dojoe/btclock/hw/fanout.pdf

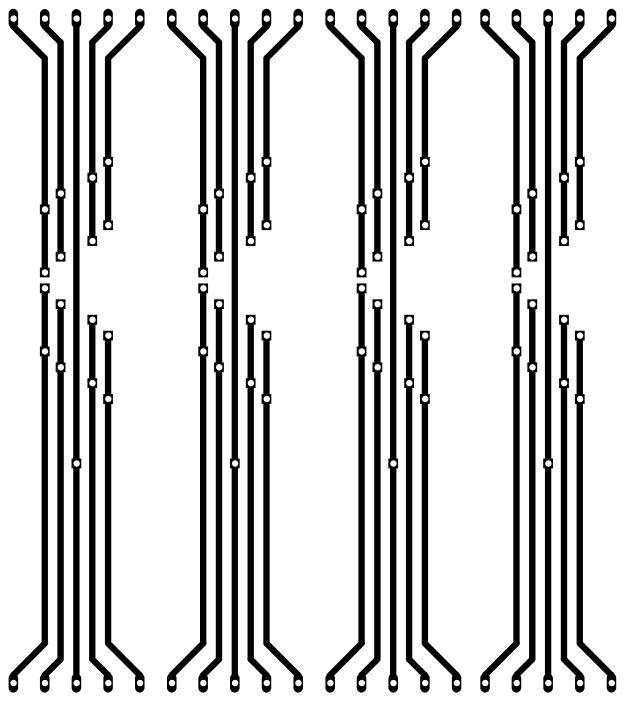
[picture p1: page 1]
