dojoe/btclock/hw/clock.brd

## EAGLE design hw/clock.brd (2013-02-22)

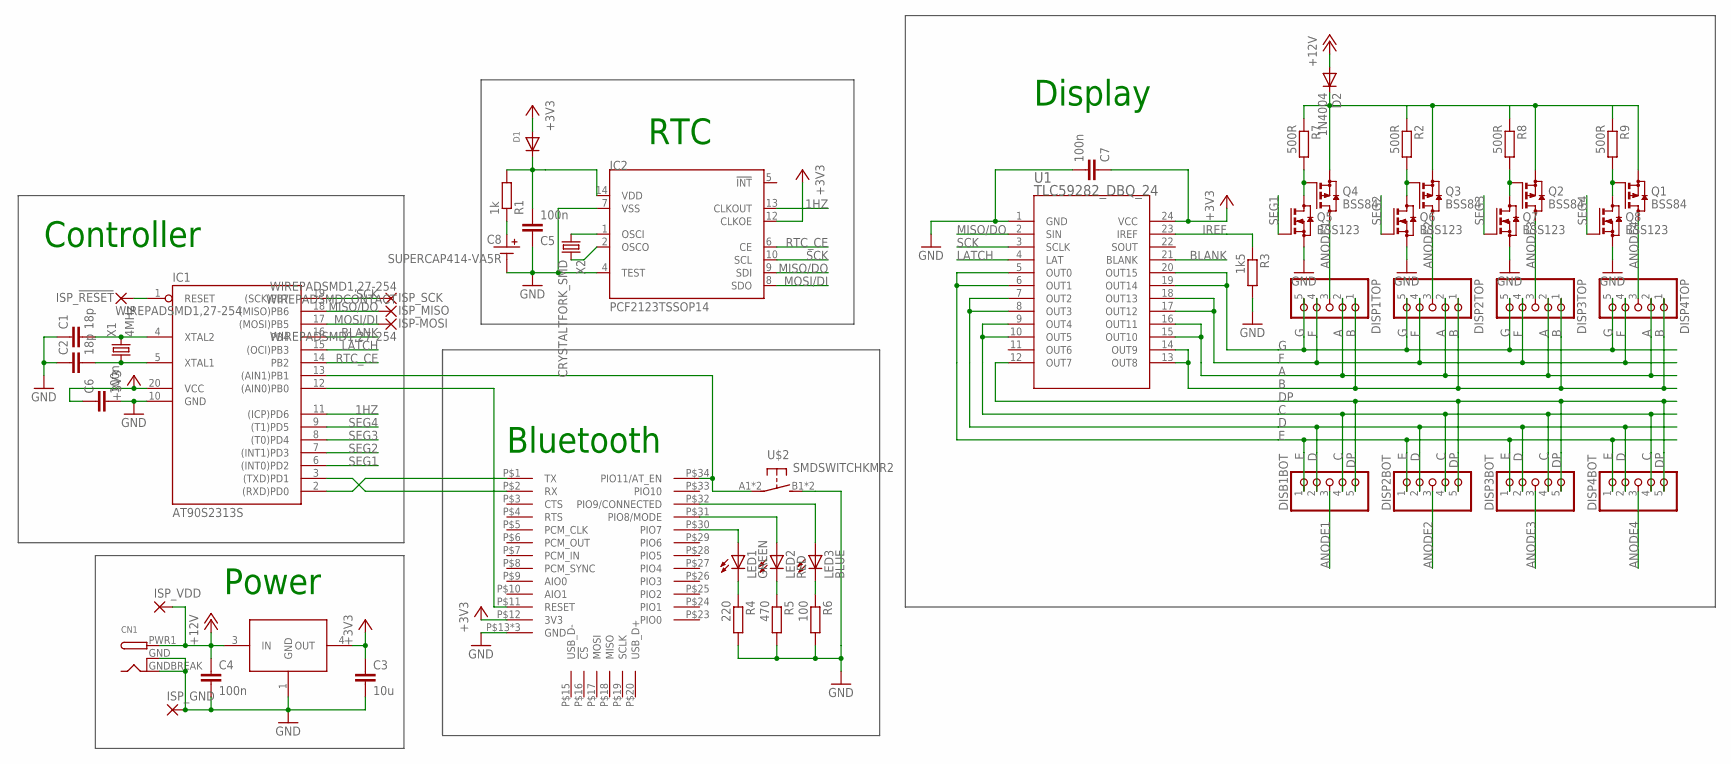
[picture p2: schematic clock.sch]

Parts:
C1, C2: 18p; C0603K
C3: 10u; C0805K
C4, C5, C6, C7: 100n; C0603K
C8: SUPERCAP414-VA5R; 414-VA5R
CN1: DCBARRELSMT; DCJACK_2MM_SMT
D1: DIODESOD-523; SOD-523
D2: 1N4004; DO41-10
DISB1BOT: PINHD-1X5; 1X05WIDE
DISP1TOP, DISP2BOT, DISP2TOP, DISP3BOT, DISP3TOP, DISP4BOT, DISP4TOP: PINHD-1X5; 1X05WIDE
IC1: AT90S2313S; SO20L
IC2: PCF2123TSSOP14; TSSOP14
ISP-MOSI: WIREPADSMD1,27-254; SMD1,27-2,54
ISP_!RESET: WIREPADSMD1,27-254; SMD1,27-2,54
ISP_GND: WIREPADSMD2,54-2,54; SMD2,54-2,54
ISP_MISO: WIREPADSMDCONTACT; SMDCONTACT
ISP_SCK: WIREPADSMD1,27-254; SMD1,27-2,54
ISP_VDD: WIREPADSMD2,54-2,54; SMD2,54-2,54
LED1: GREEN; CHIPLED_0805
LED2: RED; CHIPLED_0805
LED3: BLUE; CHIPLED_0805
Q1, Q2, Q3, Q4: BSS84; SOT23
Q5, Q6, Q7, Q8: BSS123; SOT23
R1: 1k; R0603
R2, R7, R8, R9: 500R; R0603
R3: 1k5; R0603
R4: 220; R0603
R5: 470; R0603
R6: 100; R0603
U1: TLC59282_DBQ_24; DBQ24
U$1: BT-HC-05
U$2: SMDSWITCHKMR2; KMR2
U$3: REGULATORDPAK; DPAK
X1: 4MHz; HC49UP
X2: CRYSTALTFORK_SMD; TFORK_SMD

Connections:
1HZ: IC1.11 ((ICP)PD6), IC2.13 (CLKOUT)
+3V3: C3.1, C6.1, C7.1, D1.A, IC1.20 (VCC), IC2.12 (CLKOE), U1.24 (VCC), U$1.P$12 (3V3), U$3.4 (OUT)
+12V: C4.1, CN1.PWR1 (PWR), D2.A, ISP_VDD.1, U$3.3 (IN)
A: DISP1TOP.2, DISP2TOP.2, DISP3TOP.2, DISP4TOP.2, U1.15 (OUT10), U1.16 (OUT11)
ANODE1: DISB1BOT.3, DISP1TOP.3, Q4.3 (D)
ANODE2: DISP2BOT.3, DISP2TOP.3, Q3.3 (D)
ANODE3: DISP3BOT.3, DISP3TOP.3, Q2.3 (D)
ANODE4: DISP4BOT.3, DISP4TOP.3, Q1.3 (D)
B: DISP1TOP.1, DISP2TOP.1, DISP3TOP.1, DISP4TOP.1, U1.13 (OUT8), U1.14 (OUT9)
BLANK: IC1.16 (PB4), U1.21 (BLANK)
C: DISB1BOT.4, DISP2BOT.4, DISP3BOT.4, DISP4BOT.4, U1.9 (OUT4), U1.10 (OUT5)
D: DISB1BOT.2, DISP2BOT.2, DISP3BOT.2, DISP4BOT.2, U1.7 (OUT2), U1.8 (OUT3)
DP: DISB1BOT.5, DISP2BOT.5, DISP3BOT.5, DISP4BOT.5, U1.12 (OUT7)
E: DISB1BOT.1, DISP2BOT.1, DISP3BOT.1, DISP4BOT.1, U1.5 (OUT0), U1.6 (OUT1)
F: DISP1TOP.4, DISP2TOP.4, DISP3TOP.4, DISP4TOP.4, U1.17 (OUT12), U1.18 (OUT13)
G: DISP1TOP.5, DISP2TOP.5, DISP3TOP.5, DISP4TOP.5, U1.19 (OUT14), U1.20 (OUT15)
GND: C1.1, C2.1, C3.2, C4.2, C5.1, C6.2, C7.2, C8.MINUS, CN1.GND (GNDBREAK), CN1.GNDBREAK (GND), IC1.10 (GND), IC2.4 (TEST), IC2.7 (VSS), ISP_GND.1, Q5.2 (S), Q6.2 (S), Q7.2 (S), Q8.2 (S), R3.2, R4.2, R5.2, R6.2, U1.1 (GND), U$1.P$13 (GND), U$1.P$21 (GND), U$1.P$22 (GND), U$2.B1 (S), U$2.B2 (S), U$3.1 (GND)
IREF: R3.1, U1.23 (IREF)
LATCH: IC1.15 ((OCI)PB3), U1.4 (LAT)
MISO/DO: IC1.18 ((MISO)PB6), IC2.9 (SDI), ISP_MISO.1, U1.2 (SIN)
MOSI/DI: IC1.17 ((MOSI)PB5), IC2.8 (SDO), ISP-MOSI.1
unnamed: IC1.2 ((RXD)PD0), U$1.P$1 (TX)
unnamed: IC1.3 ((TXD)PD1), U$1.P$2 (RX)
unnamed: IC2.2 (OSCO), X2.3 (2)
unnamed: IC2.1 (OSCI), X2.2 (1)
unnamed: C2.2, IC1.5 (XTAL1), X1.1
unnamed: C1.2, IC1.4 (XTAL2), X1.2
unnamed: IC1.1 (RESET), ISP_!RESET.1
unnamed: IC1.13 ((AIN1)PB1), U$1.P$34 (PIO11/AT_EN), U$2.A1, U$2.A2
unnamed: C8.PLUS, R1.1
unnamed: IC1.12 ((AIN0)PB0), U$1.P$11 (RESET)
unnamed: D2.C, Q1.2 (S), Q2.2 (S), Q3.2 (S), Q4.2 (S), R2.1, R7.1, R8.1, R9.1
unnamed: LED1.C, R4.1
unnamed: LED2.C, R5.1
unnamed: LED3.C, R6.1
unnamed: LED3.A, U$1.P$32 (PIO9/CONNECTED)
unnamed: LED2.A, U$1.P$31 (PIO8/MODE)
unnamed: LED1.A, U$1.P$30 (PIO7)
unnamed: Q1.1 (G), Q8.3 (D), R9.2
unnamed: Q2.1 (G), Q7.3 (D), R8.2
unnamed: Q3.1 (G), Q6.3 (D), R2.2
unnamed: Q4.1 (G), Q5.3 (D), R7.2
RTC_CE: IC1.14 (PB2), IC2.6 (CE)
SCK: IC1.19 ((SCK)PB7), IC2.10 (SCL), ISP_SCK.1, U1.3 (SCLK)
SEG1: IC1.6 ((INT0)PD2), Q5.1 (G)
SEG2: IC1.7 ((INT1)PD3), Q6.1 (G)
SEG3: IC1.8 ((T0)PD4), Q7.1 (G)
SEG4: IC1.9 ((T1)PD5), Q8.1 (G)
VRTC: C5.2, D1.K (C), IC2.14 (VDD), R1.2

Notes on the sheet:
Power
RTC
Controller
Bluetooth
Display

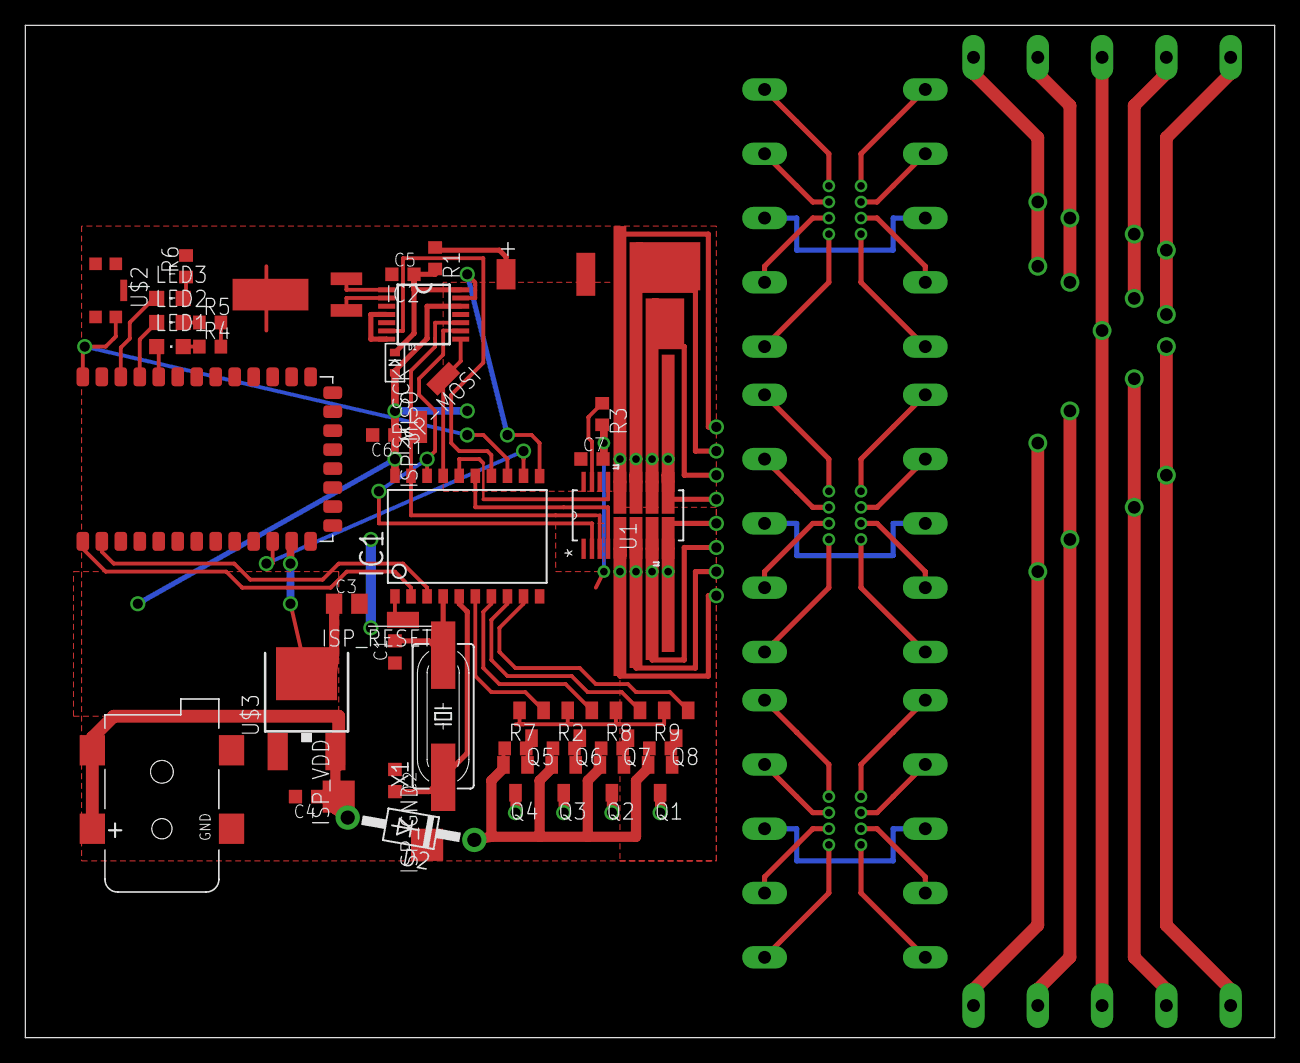
[picture p3: board clock.brd from above]

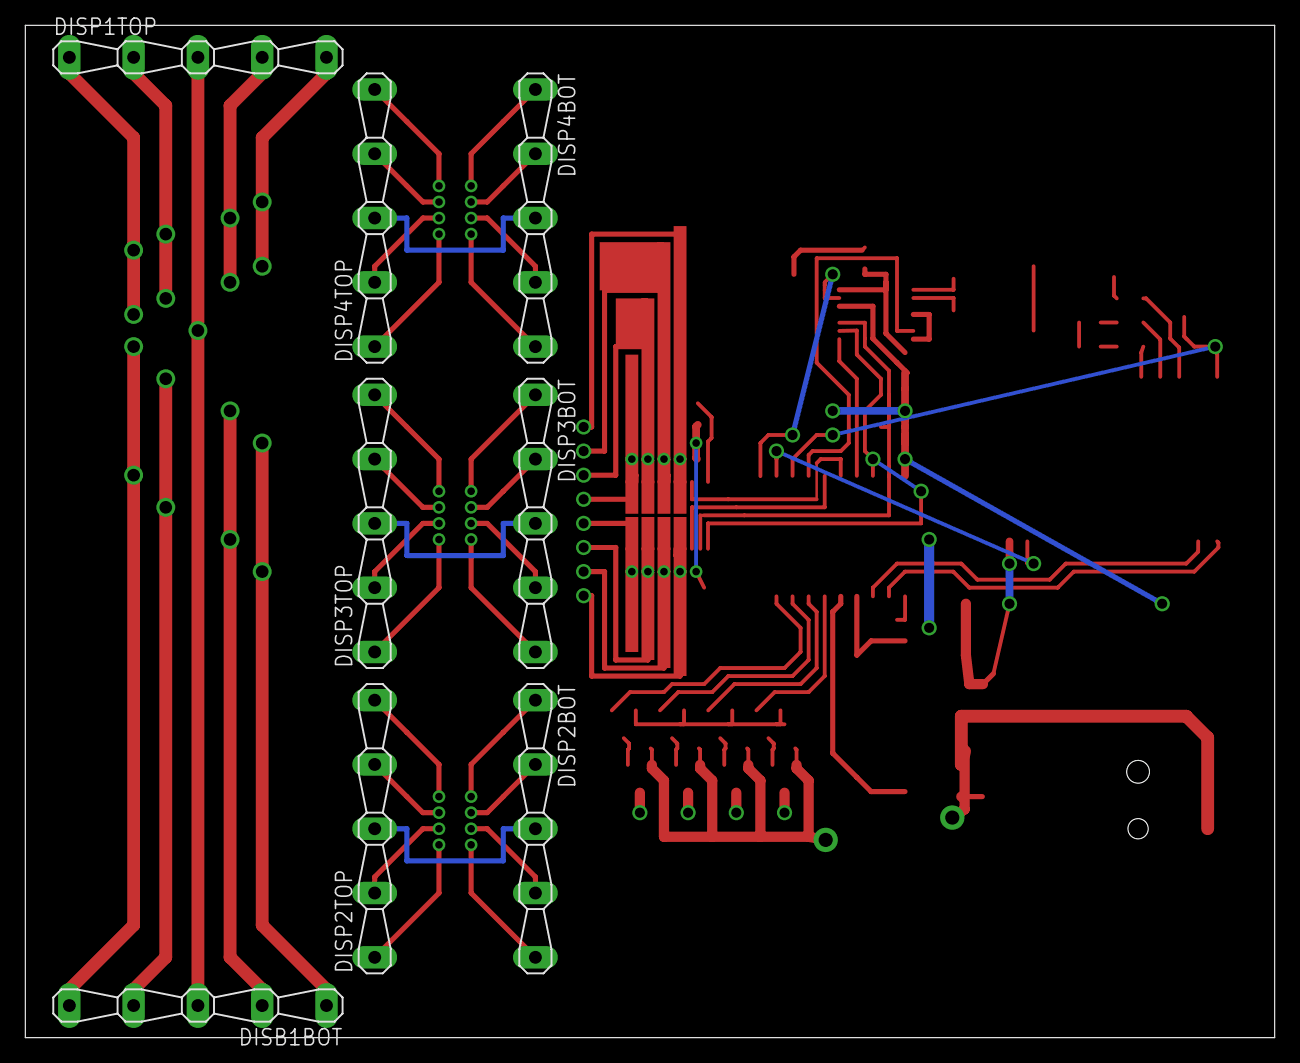
[picture p4: board clock.brd from below]

Board: 2 copper layers, 98.7 x 80.0 mm, 53 parts (8 on the bottom side), 49 nets.
