dojoe/btclock/(commit log)

2013-01-31 Initial commit, including reverse SPI bug on PCB
    [bom.csv, clock.brd, clock.sch]
2013-01-31 Fix reversed SPI lines, remove superfluous pull-up on RTC.CLKOUT, improve vias.
    [clock.brd, clock.sch]
2013-02-06 Connect button to BT module's AT_ENABLE pin
    [clock.brd, clock.sch]
2013-02-06 Kludge shared Button/BT_AT pin, get RTC working, enable TLC
2013-02-10 Add case layout
2013-02-15 Date mode, better scrolling, PIN setup. Also don't drink and code =/
2013-02-16 Reduce static RAM usage a bit, fixing stack overruns
    [bt.c, rtc.c, uart.c, uart.h]
2013-02-22 HW v2.0, with proper level shifters
    [clock.brd, clock.sch]
2013-02-25 Proper fullstop support, size optimizations, some bugfixes
    [btclock.h, cmd.c, config.c, config.h, main.c, rtc.c, tlc.c]
2013-02-25 Make sure changing PIN also works during blank times
2013-02-26 Shrink UART code, print scroll mode with lines
2013-03-17 Add support for Board v2
2013-10-27 Print bad commands, ignore disconnect messages, save a few bytes somewhere else so we still fit into 4K =/
2014-04-06 Fix countdown running at double speed
    [board.h, pins.h, rtc.c]
